alexandreaedy-jpg/APU-8/milestones/APU8_failed_fastdiag_20260423-142117/project-separate-channels/dmc-source-samples/README.md

# DMC Source Samples

Selection 808 copied locally from the Ableton Core Library for DMC experiments.

Files:

- `808_kick.aif`
- `808_snare.aif`
- `808_hihat_closed.aif`
- `808_hihat_open.aif`
- `808_clap.aif`

Suggested first-pass trims for NES DMC:

- `808_kick.aif`: keep the first `50-80 ms`
- `808_snare.aif`: keep the first `70-120 ms`
- `808_hihat_closed.aif`: keep the first `20-40 ms`
- `808_hihat_open.aif`: keep the first `40-80 ms`
- `808_clap.aif`: optional, keep the first `40-90 ms`

Likely first useful DMC set:

- `kick`
- `snare`
- `closed hat`

Then compare against:

- `open hat`
- `clap`
