alexandreaedy-jpg/APU-8/Archive/README.md

# Archive

This folder keeps older APU-8 iterations out of the main workspace while preserving the source history.

## Contents

- `Project-V2-A/`
  - archived V2A and V2B ROM step folders
- `arduino/`
  - archived Nano and Pico sketch history
- `legacy-root/`
  - older controller-port branches and side experiments that used to live at the repository root

## Notes

- The current active ROM source stays in `..\Project-V2-A\v2b_step5ar_flat_env_pitch`
- The current active Pico sketch stays in `..\arduino\PicoNesV2B_Step5ARFlatEnvPitch`
- Historical shortcuts still work through `.\tools\v2.cmd`, including:
  - `midi-v2a`
  - `midi-v2b1` to `midi-v2b21`
