alexandreaedy-jpg/APU-8/hardware/APU8_V2B_KiCad_Project/APU8_V2B_Interface.kicad_pcb

## KiCad design hardware/APU8_V2B_KiCad_Project/APU8_V2B_Interface.kicad_pcb (2026-08-19)

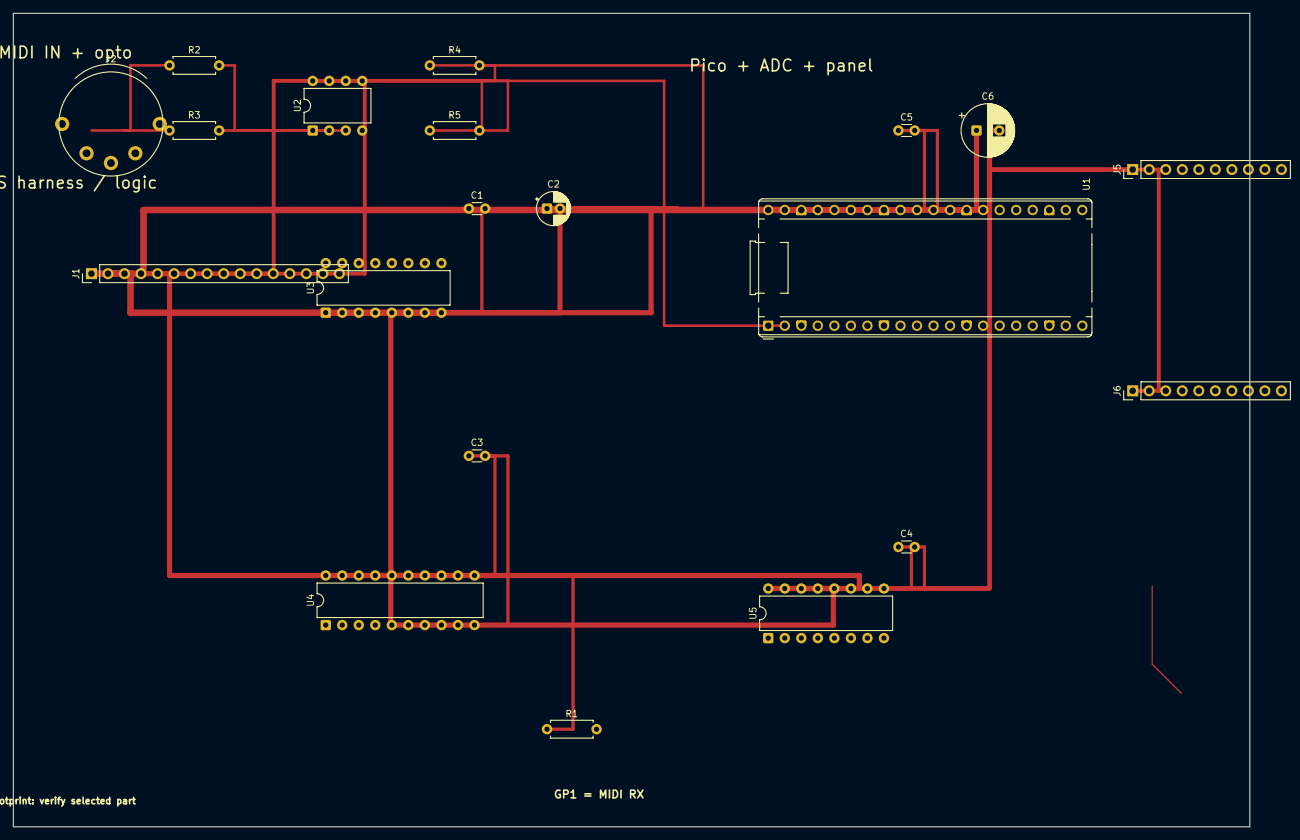
[picture p1: board APU8_V2B_Interface.kicad_pcb from above]

Board: 2 copper layers, 190.0 x 125.0 mm, 20 parts (0 on the bottom side), 51 nets.

Parts:
C1: 100n 3V3; C_Disc_D3.0mm_W1.6mm_P2.50mm
C2: 10u 3V3; CP_Radial_D5.0mm_P2.00mm
C3: 100n 5V HC245; C_Disc_D3.0mm_W1.6mm_P2.50mm
C4: 100n 5V MCP; C_Disc_D3.0mm_W1.6mm_P2.50mm
C5: 100n 5V bulk local; C_Disc_D3.0mm_W1.6mm_P2.50mm
C6: 47u 5V; CP_Radial_D8.0mm_P3.50mm
J1: NES_HARNESS; PinHeader_1x16_P2.54mm_Vertical
J2: MIDI_DIN_IN; DIN5_180_Placeholder_THT
J5: PANEL_ANALOG; PinHeader_1x10_P2.54mm_Vertical
J6: PANEL_SWITCHES; PinHeader_1x10_P2.54mm_Vertical
R1: 10k; R_Axial_DIN0207_L6.3mm_D2.5mm_P7.62mm_Horizontal
R2, R3: 220R; R_Axial_DIN0207_L6.3mm_D2.5mm_P7.62mm_Horizontal
R4: 4k7; R_Axial_DIN0207_L6.3mm_D2.5mm_P7.62mm_Horizontal
R5: 1k; R_Axial_DIN0207_L6.3mm_D2.5mm_P7.62mm_Horizontal
U1: RaspberryPi_Pico; RaspberryPi_Pico_Common_THT
U2: 6N138; DIP-8_W7.62mm
U3: 74HC4050; DIP-16_W7.62mm
U4: 74HCT245; DIP-20_W7.62mm
U5: MCP3008; DIP-16_W7.62mm

Connections:
3V3: C1.1, C2.1, R4.1, U1.36, U3.1
+5V: C3.1, C4.1, C5.1, C6.1, J1.1, J5.1, R1.1, U1.39, U2.8, U4.1, U4.20, U5.15, U5.16
A15_OPTIONAL: J1.13, U3.11
GND: C1.2, C2.2, C3.2, C4.2, C5.2, C6.2, J1.2, J1.3, J5.2, J6.1, R5.2, U1.3, U1.8, U1.13, U1.18, U1.23, U1.28, U1.33, U1.38, U2.5, U3.8, U4.10, U5.9, U5.14
GP2_OUT0: U1.4, U3.2
GP3_OUT1: U1.5, U3.4
GP4_OUT2: U1.6, U3.6
GP5_OE2_N: U1.7, U3.10
GP6_A15: U1.9, U3.12
GP10_D0: U1.14, U4.2
GP11_D1: U1.15, U4.3
GP12_D2: U1.16, U4.4
GP13_D3: U1.17, U4.5
GP14_D4: U1.19, U4.6
GP16_MISO: U1.21, U5.12
GP17_CS: U1.22, U5.10
GP18_SCK: U1.24, U5.13
GP19_MOSI: U1.25, U5.11
HCT245_OE_N: R1.2, U1.10, U4.19
MIDI_LED_A: R2.2, U2.2
MIDI_LED_K: R3.2, U2.3
MIDI_PIN4: J2.4, R2.1
MIDI_PIN5: J2.5, R3.1
MIDI_RX: R4.2, U1.2, U2.6
MIDI_SPEED: R5.1, U2.7
OE2_N: J1.7, U3.9
OUT0: J1.6, U3.3
OUT1: J1.5, U3.5
OUT2: J1.4, U3.7
PORT1_0: J1.8, U4.18
PORT1_1: J1.9, U4.17
PORT1_2: J1.10, U4.16
PORT1_3: J1.11, U4.15
PORT1_4: J1.12, U4.14
POT_ARP_TIME_OR_WAVE: J5.10, U5.8
POT_ATTACK: J5.3, U5.1
POT_DECAY: J5.5, U5.3
POT_DUTY_OR_TIMBRE: J5.9, U5.7
POT_LFO_DEPTH: J5.7, U5.5
POT_LFO_RATE: J5.8, U5.6
POT_RELEASE: J5.6, U5.4
POT_VOLUME: J5.4, U5.2
SW_ARP: J6.10, U1.34
SW_GLOBAL: J6.9, U1.32
SW_LFO_AMP: J6.4, U1.20
SW_LFO_DUTY: J6.3, U1.12
SW_LFO_PITCH: J6.2, U1.11
SW_NOISE: J6.8, U1.31
SW_P1: J6.5, U1.26
SW_P2: J6.6, U1.27
SW_TRI: J6.7, U1.29
