alexandreaedy-jpg/APU-8/(commit log)

2026-05-04 Initial commit APU8 v16 to v18
    [nrom_256_vert.cfg]
2026-08-19 Archive current APU-8 development state
    [APU8_V2B_Interface OK.kicad_sch, APU8_V2B_Interface.kicad_pcb, APU8_V2B_Interface.kicad_sch, APU8_V2B_pinmap.csv, nrom_256_vert.cfg]
2026-08-19 Archive current APU-8 development state (#1)
    [APU8_V2B_Interface OK.kicad_sch, APU8_V2B_Interface.kicad_pcb, APU8_V2B_Interface.kicad_sch, APU8_V2B_pinmap.csv, nrom_256_vert.cfg]
2026-08-19 Clarify V2 usage and add samples section in README
    Updated README to clarify the use of the NES-001 bottom expansion port in V2 and added a mention of samples.
2026-08-19 Reorganize repo layout and archive old versions
    [nrom_256_vert.cfg]
2026-08-19 Rename active V2B folders and prune legacy notes
    [nrom_256_vert.cfg]
